picatostas/4dof_robot/README.md

# 4dof_robot
This is the repository for my final degree project, including PCB files, Arduino Code, 3D files, etc.
