picatostas/4dof_robot/Eagle_PCB_files/AS5040_board/SSI_Interface/AS5040_SSI.brd

## EAGLE design Eagle_PCB_files/AS5040_board/SSI_Interface/AS5040_SSI.brd (2018-07-02)

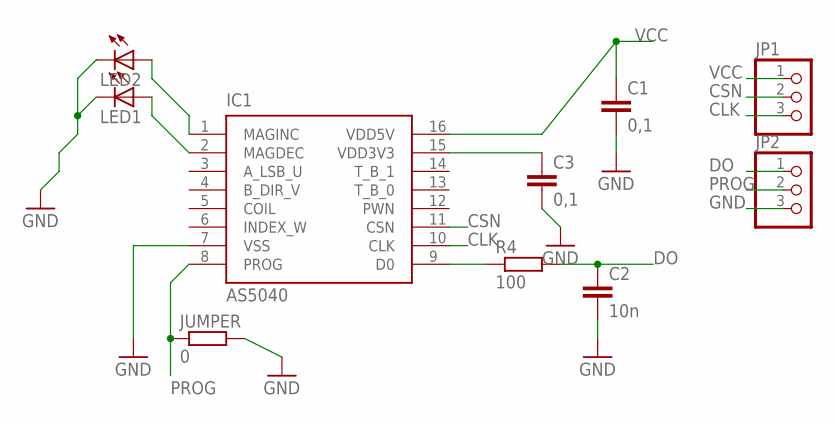
[picture p1: schematic AS5040_SSI.sch]

Parts:
C1, C3: 0,1; C0805
C2: 10n; C0805
IC1: AS5040; SSOP16
JP1, JP2: PINHD-1X3; 1X03
JUMPER: 0; M0805
LED1, LED2: LEDCHIPLED_0805; CHIPLED_0805
R4: 100; M0805

Connections:
CLK: IC1.10 (CLK), JP1.3
CSN: IC1.11 (CSN), JP1.2
DO: C2.1, JP2.1, R4.2
GND: C1.2, C2.2, C3.2, IC1.7 (VSS), JP2.3, JUMPER.2, LED1.C, LED2.C
unnamed: IC1.9 (D0), R4.1
unnamed: IC1.1 (MAGINC), LED2.A
unnamed: IC1.2 (MAGDEC), LED1.A
unnamed: C3.1, IC1.15 (VDD3V3)
PROG: IC1.8 (PROG), JP2.2, JUMPER.1
VCC: C1.1, IC1.16 (VDD5V), JP1.1

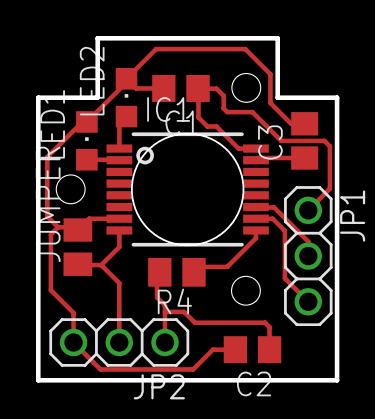
[picture p2: board AS5040_SSI.brd from above]

Board: 2 copper layers, 16.6 x 19.0 mm, 10 parts (0 on the bottom side), 10 nets.
