picatostas/4dof_robot/Eagle_PCB_files/DRV8833_board/DRV8833.brd

## EAGLE design Eagle_PCB_files/DRV8833_board/DRV8833.brd (2018-07-02)

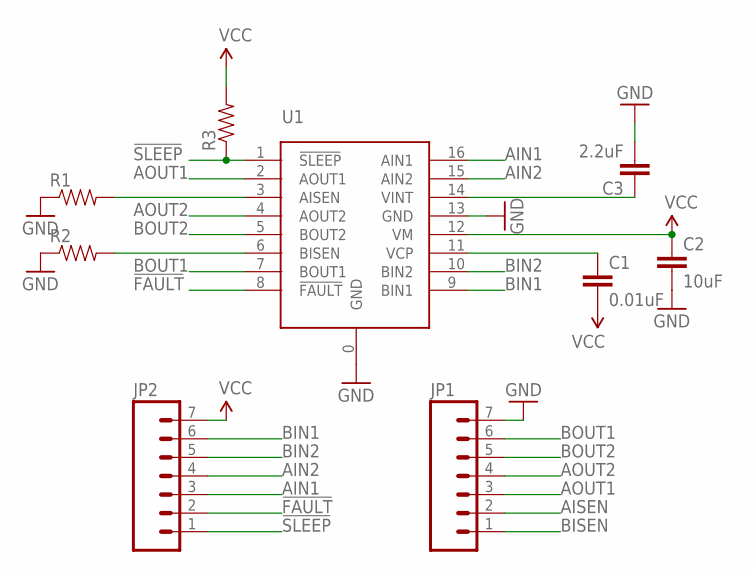
[picture p3: schematic DRV8833.sch]

Parts:
C1: 0.01uF; 0603-CAP
C2: 10uF; 1206
C3: 2.2uF; 0603-CAP
JP1, JP2: M07; 1X07
R1, R2: RESISTOR1206; 1206
R3: RESISTOR0603-RES; 0603-RES
U1: DRV8833; PWP16

Connections:
!FAULT: JP2.2, U1.8 (!FAULT)
!SLEEP: JP2.1, R3.1, U1.1 (!SLEEP)
AIN1: JP2.3, U1.16 (AIN1)
AIN2: JP2.4, U1.15 (AIN2)
AISEN: JP1.2, R1.2, U1.3 (AISEN)
AOUT1: JP1.3, U1.2 (AOUT1)
AOUT2: JP1.4, U1.4 (AOUT2)
BIN1: JP2.6, U1.9 (BIN1)
BIN2: JP2.5, U1.10 (BIN2)
BISEN: JP1.1, R2.2, U1.6 (BISEN)
BOUT1: JP1.6, U1.7 (BOUT1)
BOUT2: JP1.5, U1.5 (BOUT2)
GND: C2.2, C3.2, JP1.7, R1.1, R2.1, U1.0 (GND), U1.13 (GND)
unnamed: C1.1, U1.11 (VCP)
unnamed: C3.1, U1.14 (VINT)
VCC: C1.2, C2.1, JP2.7, R3.2, U1.12 (VM)

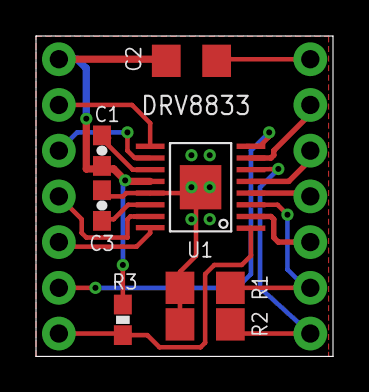
[picture p4: board DRV8833.brd from above]

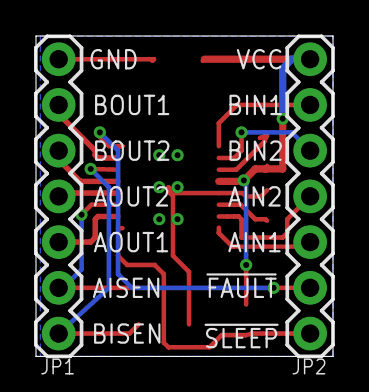
[picture p5: board DRV8833.brd from below]

Board: 2 copper layers, 16.5 x 17.8 mm, 9 parts (2 on the bottom side), 16 nets.
