picatostas/4dof_robot/Eagle_PCB_files/mother_board/mother_board.brd

## EAGLE design Eagle_PCB_files/mother_board/mother_board.brd (2018-07-02)

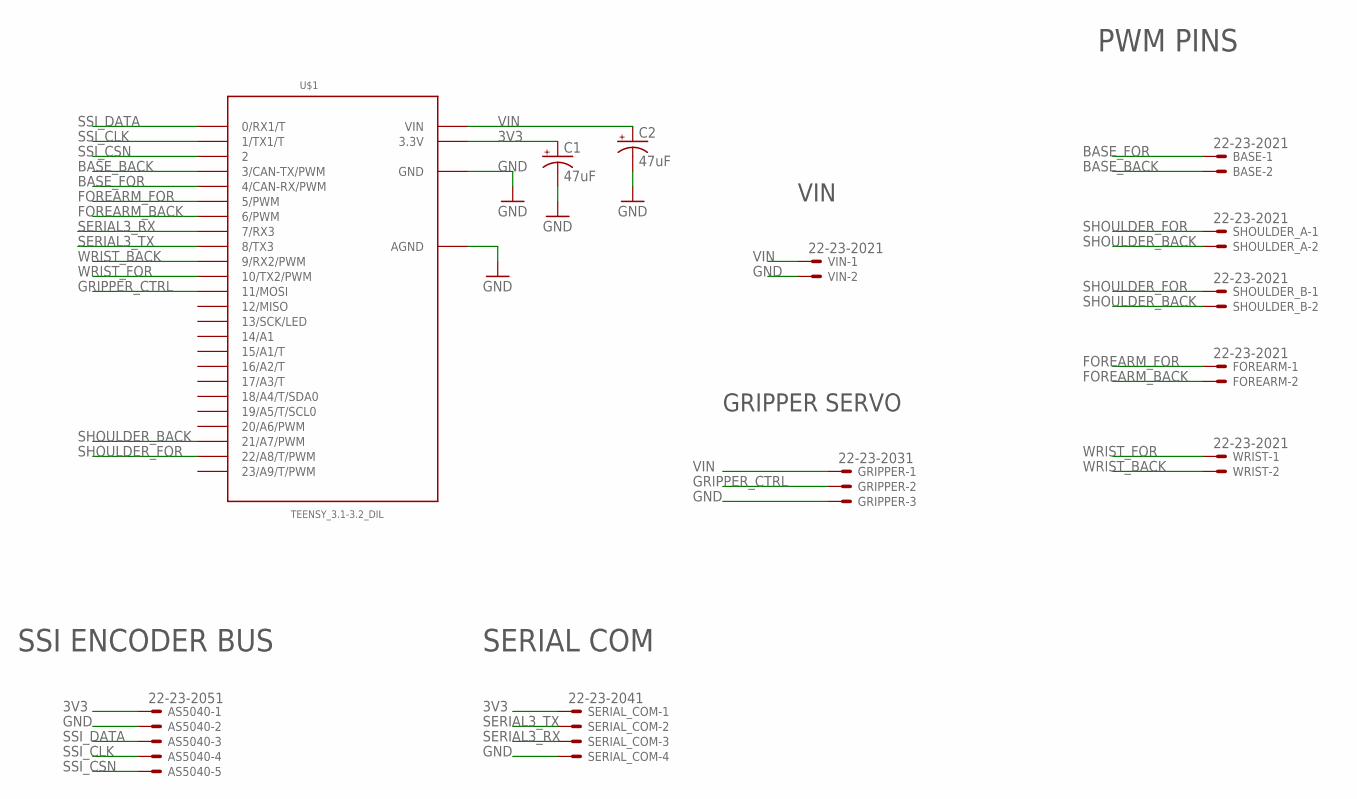
[picture p6: schematic mother_board.sch]

Parts:
AS5040: 22-23-2051
BASE: 22-23-2021
C1, C2: 47uF; E2,5-7
FOREARM: 22-23-2021
GRIPPER: 22-23-2031
SERIAL_COM: 22-23-2041
SHOULDER_A: 22-23-2021
SHOULDER_B: 22-23-2021
U$1: TEENSY_3.1-3.2_DIL; TEENSY_3.0-3.2&LC_DIL
VIN: 22-23-2021
WRIST: 22-23-2021

Connections:
3V3: AS5040.1, C1.+, SERIAL_COM.1, U$1.3.3V
BASE_BACK: BASE.2, U$1.3 (3/CAN-TX/PWM)
BASE_FOR: BASE.1, U$1.4 (4/CAN-RX/PWM)
FOREARM_BACK: FOREARM.2, U$1.6 (6/PWM)
FOREARM_FOR: FOREARM.1, U$1.5 (5/PWM)
GND: AS5040.2, C1.-, C2.-, GRIPPER.3, SERIAL_COM.4, U$1.AGND, U$1.GND, VIN.2
GRIPPER_CTRL: GRIPPER.2, U$1.11 (11/MOSI)
SERIAL3_RX: SERIAL_COM.3, U$1.7 (7/RX3)
SERIAL3_TX: SERIAL_COM.2, U$1.8 (8/TX3)
SHOULDER_BACK: SHOULDER_A.2, SHOULDER_B.2, U$1.21/A7 (21/A7/PWM)
SHOULDER_FOR: SHOULDER_A.1, SHOULDER_B.1, U$1.22/A8 (22/A8/T/PWM)
SSI_CLK: AS5040.4, U$1.1 (1/TX1/T)
SSI_CSN: AS5040.5, U$1.2
SSI_DATA: AS5040.3, U$1.0 (0/RX1/T)
VIN: C2.+, GRIPPER.1, U$1.VIN, VIN.1
WRIST_BACK: U$1.9 (9/RX2/PWM), WRIST.2
WRIST_FOR: U$1.10 (10/TX2/PWM), WRIST.1

Notes on the sheet:
PWM PINS
SSI ENCODER BUS
SERIAL COM
GRIPPER SERVO
VIN

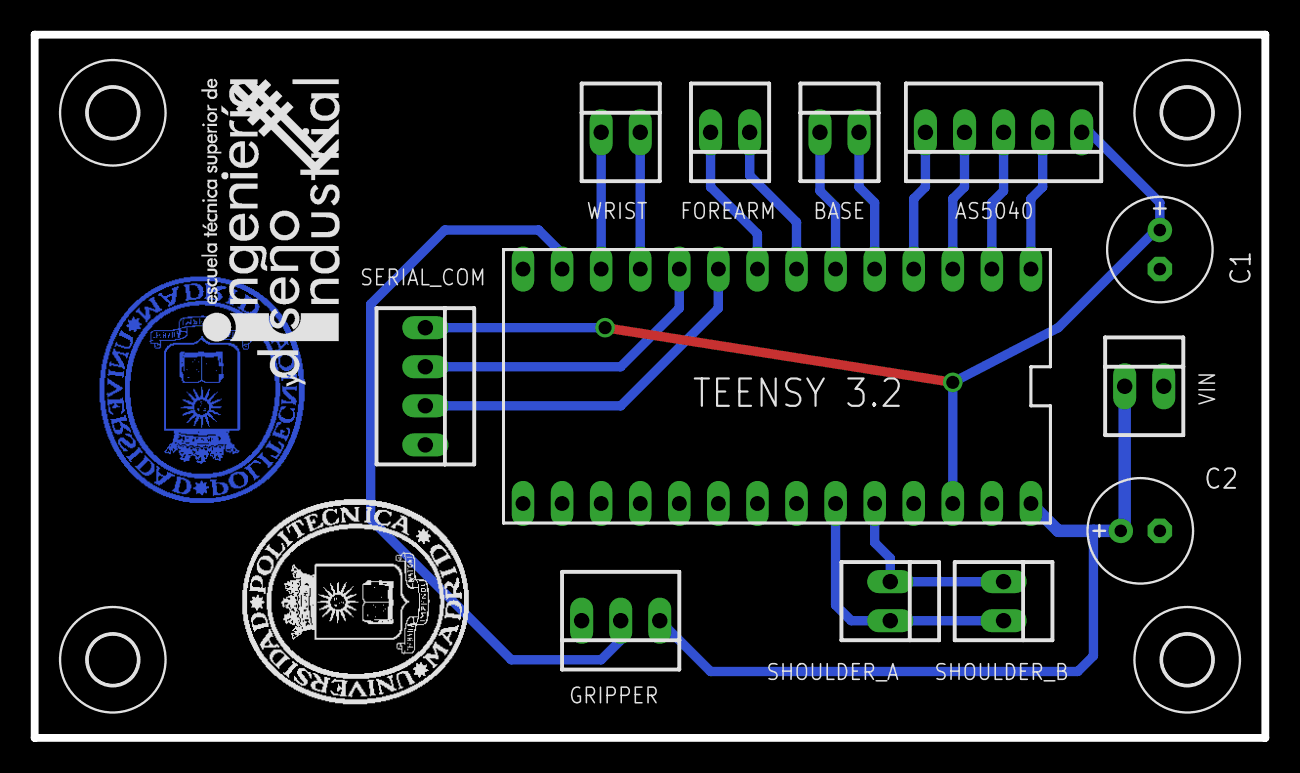
[picture p7: board mother_board.brd from above]

Board: 2 copper layers, 80.0 x 45.7 mm, 19 parts (1 on the bottom side), 17 nets.

Other parts of the board:
U$2, U$3, U$4, U$5: 3,2
U$6: LOGO_UPM_NAMES
U$7: LOGO_ETSIDI_NAMES
U$8: LOGO_UPM_TOP1
