picatostas/4dof_robot/Eagle_PCB_files/AS5040_board/Cuadrature_Interface/AS5040_Cuadrature.brd

## EAGLE design Eagle_PCB_files/AS5040_board/Cuadrature_Interface/AS5040_Cuadrature.brd (2018-07-02)

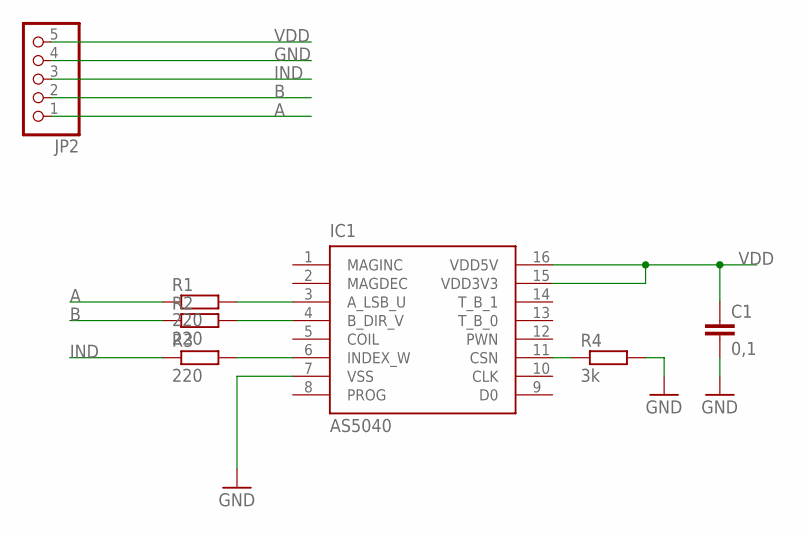
[picture p8: schematic AS5040_Cuadrature.sch]

Parts:
C1: 0,1; C0805
IC1: AS5040; SSOP16
JP2: PINHD-1X5; 1X05
R1, R2, R3: 220; M0805
R4: 3k; M0805

Connections:
A: JP2.1, R1.1
B: JP2.2, R2.1
GND: C1.2, IC1.7 (VSS), JP2.4, R4.2
IND: JP2.3, R3.1
unnamed: IC1.6 (INDEX_W), R3.2
unnamed: IC1.3 (A_LSB_U), R1.2
unnamed: IC1.4 (B_DIR_V), R2.2
unnamed: IC1.11 (CSN), R4.1
VDD: C1.1, IC1.15 (VDD3V3), IC1.16 (VDD5V), JP2.5

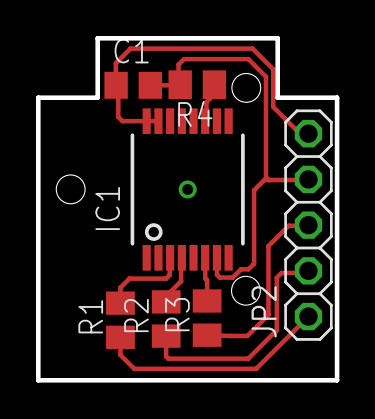
[picture p9: board AS5040_Cuadrature.brd from above]

Board: 2 copper layers, 16.6 x 19.0 mm, 7 parts (0 on the bottom side), 9 nets.
