picatostas/4dof_robot/Eagle_PCB_files/motor_driver_board/motor-control-board.brd

## EAGLE design Eagle_PCB_files/motor_driver_board/motor-control-board.brd (2018-07-02)

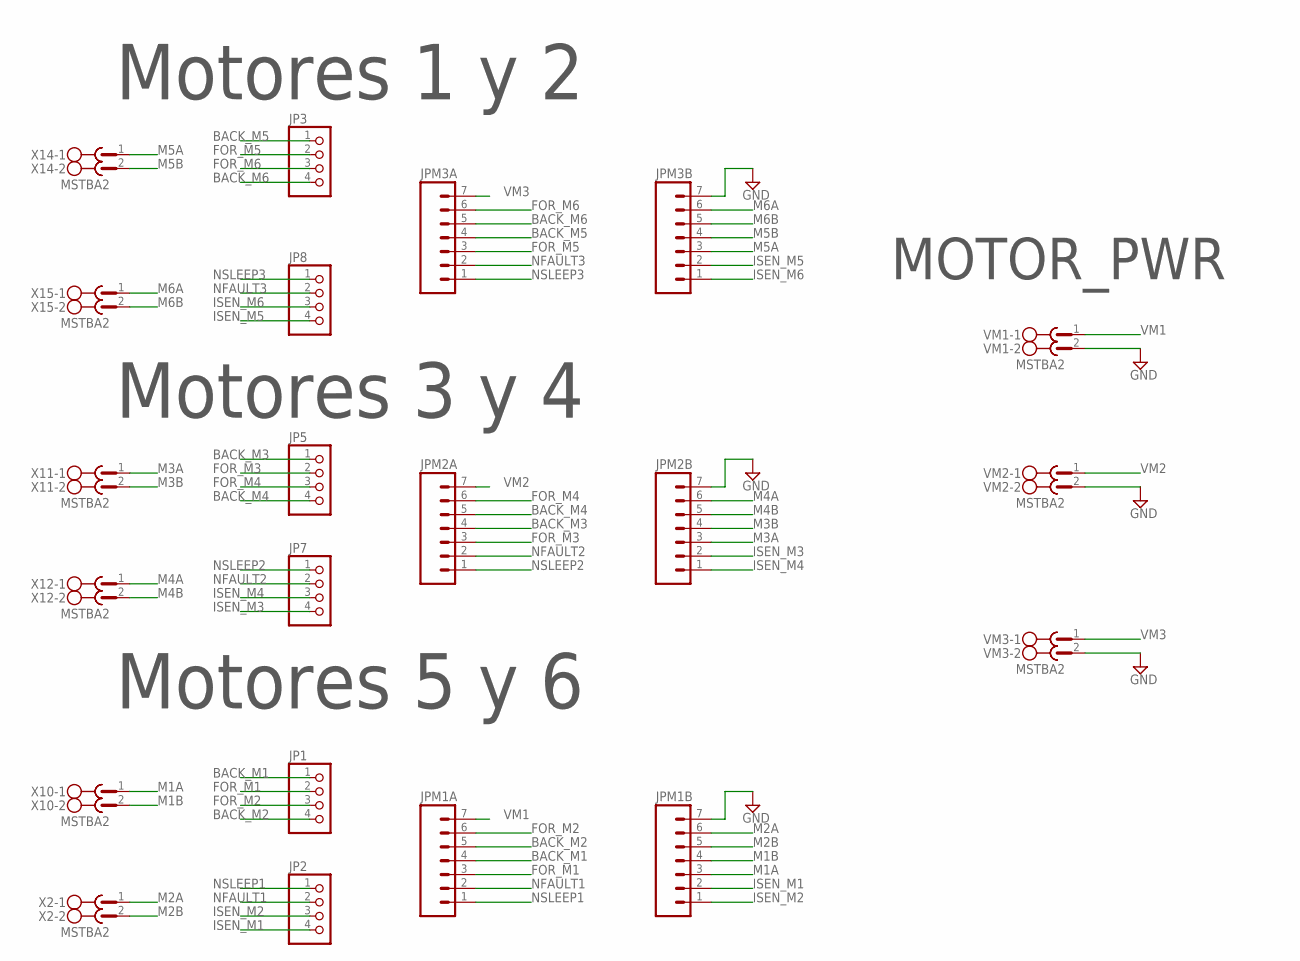
[picture p10: schematic motor-control-board.sch]

Parts:
JP1, JP2, JP3, JP5, JP7, JP8: PINHD-1X4; 1X04
JPM1A, JPM1B, JPM2A, JPM2B, JPM3A, JPM3B: M07; 1X07
VM1, VM2, VM3: MSTBA2
X2, X10, X11, X12, X14, X15: MSTBA2

Connections:
BACK_M1: JP1.1, JPM1A.4
BACK_M2: JP1.4, JPM1A.5
BACK_M3: JP5.1, JPM2A.4
BACK_M4: JP5.4, JPM2A.5
BACK_M5: JP3.1, JPM3A.4
BACK_M6: JP3.4, JPM3A.5
FOR_M1: JP1.2, JPM1A.3
FOR_M2: JP1.3, JPM1A.6
FOR_M3: JP5.2, JPM2A.3
FOR_M4: JP5.3, JPM2A.6
FOR_M5: JP3.2, JPM3A.3
FOR_M6: JP3.3, JPM3A.6
GND: JPM1B.7, JPM2B.7, JPM3B.7, VM1.2, VM2.2, VM3.2
ISEN_M1: JP2.4, JPM1B.2
ISEN_M2: JP2.3, JPM1B.1
ISEN_M3: JP7.4, JPM2B.2
ISEN_M4: JP7.3, JPM2B.1
ISEN_M5: JP8.4, JPM3B.2
ISEN_M6: JP8.3, JPM3B.1
M1A: JPM1B.3, X10.1
M1B: JPM1B.4, X10.2
M2A: JPM1B.6, X2.1
M2B: JPM1B.5, X2.2
M3A: JPM2B.3, X11.1
M3B: JPM2B.4, X11.2
M4A: JPM2B.6, X12.1
M4B: JPM2B.5, X12.2
M5A: JPM3B.3, X14.1
M5B: JPM3B.4, X14.2
M6A: JPM3B.6, X15.1
M6B: JPM3B.5, X15.2
NFAULT1: JP2.2, JPM1A.2
NFAULT2: JP7.2, JPM2A.2
NFAULT3: JP8.2, JPM3A.2
NSLEEP1: JP2.1, JPM1A.1
NSLEEP2: JP7.1, JPM2A.1
NSLEEP3: JP8.1, JPM3A.1
VM1: JPM1A.7, VM1.1
VM2: JPM2A.7, VM2.1
VM3: JPM3A.7, VM3.1

Notes on the sheet:
Motores 1 y 2
MOTOR_PWR
Motores 3 y 4
Motores 5 y 6

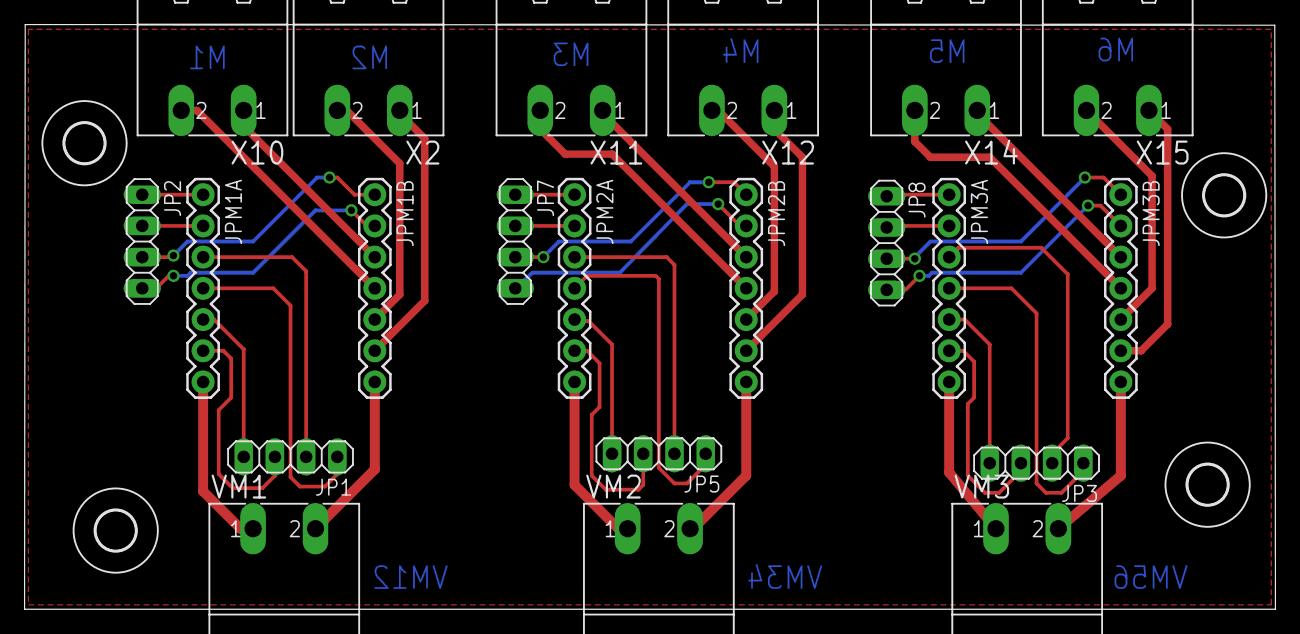
[picture p11: board motor-control-board.brd from above]

Board: 2 copper layers, 101.8 x 47.6 mm, 25 parts (0 on the bottom side), 40 nets.

Other parts of the board:
U$10, U$11, U$12, U$13: 3,2
