picatostas/4dof_robot/Teensy_code_files/AS5040.cpp

#include <Arduino.h>
#include "AS5040.h"

AS5040::AS5040(uint16_t DataPin, uint16_t ClockPin, uint16_t ChipSelectPin)
           : _data(DataPin), _clock(ClockPin), _cs(ChipSelectPin)
{
    pinMode(_data, INPUT);
    pinMode(_clock, OUTPUT);
    pinMode(_cs, OUTPUT);
}


uint32_t AS5040::encoder_degrees(void)
{
  return ((encoder_value() * 360)/1024);
}

uint32_t AS5040::encoder_value(void)
{
  return (read_chip() >> 6);
}

uint32_t AS5040::encoder_error(void)
{
  uint16_t error_code;  // not yet implemented
  uint32_t raw_value;
  raw_value = read_chip();
  error_code = raw_value & 0b0000000000111111;
  err_value.DECn = error_code & 2;
  err_value.INCn = error_code & 4;
  err_value.LIN = error_code & 8;
  err_value.COF = error_code & 16;
  err_value.OCF = error_code & 32;
  return error_code;
}

uint32_t AS5040::read_chip(void)
{
  uint32_t raw_value = 0;
  uint16_t inputstream = 0;
  uint16_t c;
  digitalWrite(_cs, HIGH);
  digitalWrite(_clock, HIGH);
  delayMicroseconds(10);
  digitalWrite(_cs, LOW);
  delayMicroseconds(1);
  digitalWrite(_clock, LOW);
  delayMicroseconds(1);
  for (c = 0; c < 16; c++)
  {
    digitalWrite(_clock, HIGH);
    delayMicroseconds(1);
    inputstream = digitalRead(_data);
    raw_value = ((raw_value << 1) + inputstream);
    digitalWrite(_clock, LOW);
    delayMicroseconds(1);
  }
 return raw_value;
}
void AS5040::read_array_chip(double array[],int dim_array)
{
  
  //uint16_t c; // es el contador
  // habilitacion de lectura 
  digitalWrite(_cs, HIGH);
  digitalWrite(_clock, HIGH);
  delayMicroseconds(10);
  digitalWrite(_cs, LOW);
  delayMicroseconds(1);
  digitalWrite(_clock, LOW);
  delayMicroseconds(1);
  for (int i = 0;i< dim_array ; i++)
  {
    uint32_t raw_value = 0;
    uint16_t inputstream = 0;
    uint16_t c;
    for (c = 0; c < 16; c++)
    {
      digitalWrite(_clock, HIGH);
      delayMicroseconds(1);
      inputstream = digitalRead(_data);
      raw_value = ((raw_value << 1) + inputstream);
      digitalWrite(_clock, LOW);
      delayMicroseconds(1);
    }
    digitalWrite(_clock, HIGH);
    delayMicroseconds(1);
        digitalWrite(_clock, LOW);
    delayMicroseconds(1);
    array[i] = (double)(raw_value  >> 6)*360.00/1024.00;
  }
}
